Dean27817/Universal-Melty-AIO/README.md

# Universal-Melty-AIO
A repository of code and hardware files for a universal melty board that uses two accelerometers to make a PCB that should be able to work in any meltybrain battlebot.
