Dean27817/Universal-Melty-AIO/PCB/AIOMeltyV3.kicad_pcb

## KiCad design PCB/AIOMeltyV3.kicad_pcb (2025-08-06)

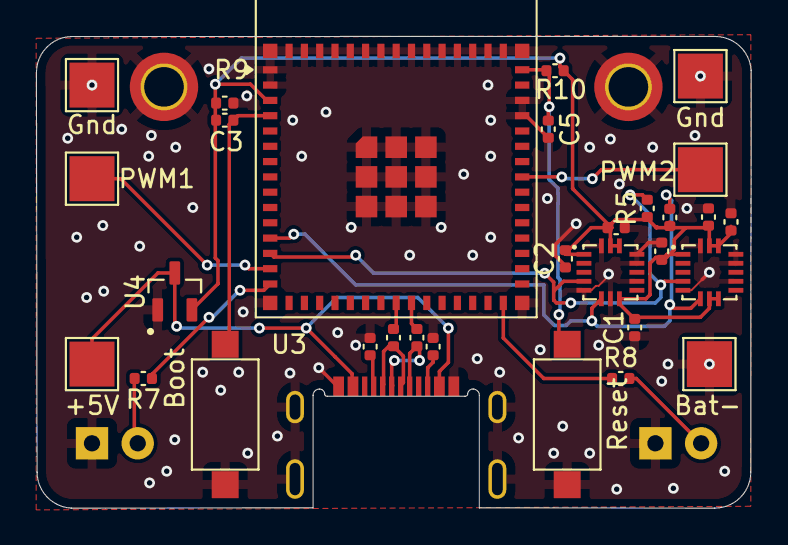
[picture p1: board AIOMeltyV3.kicad_pcb from above]

Board: 2 copper layers, 39.7 x 26.2 mm, 33 parts (0 on the bottom side), 17 nets.

Parts:
C1, C1#2, C2, C3, C4, C5, C12, C13: 100nf; C_0402_1005Metric
D1, D2: CQY99; LED_D5.0mm_IRGrey
H1: PWM1; TestPoint_Pad_2.5x2.5mm
H2: PWM2; TestPoint_Pad_2.5x2.5mm
H3: Bat-; TestPoint_Pad_2.5x2.5mm
H3#2, H3#3: Gnd; TestPoint_Pad_2.5x2.5mm
H4: +5V; TestPoint_Pad_2.5x2.5mm
J1: USB4500-03-0-A_REVA1; GCT_USB4500-03-0-A_REVA1
R1, R2: 27.4; C_0402_1005Metric
R3, R4: 5.1k; C_0402_1005Metric
R5, R6, R9, R10: 10k; C_0402_1005Metric
R7, R8: R; C_0402_1005Metric
SW1: Boot; SW_SPST_CK_RS282G05A3
SW2: Reset; SW_SPST_CK_RS282G05A3
U1, U2: QFN300X300X100-16N
U3: ESP32-S3-MINI-1; ESP32-S2-MINI-1
U4: RT9161A-33GV; 5-3.3V LDO

Connections:
+3V3: C1.2, C1#2.2, C2.2, C3.2, C4.1, C12.1, C13.1, R5.1, R6.1, R9.1, R10.1, U1.1 (VDD_IO), U1.8 (CS), U1.14 (VDD), U1.15 (VDD), U2.1 (VDD_IO), U2.7 (SDO), U2.8 (CS), U2.14 (VDD), U2.15 (VDD), U3.3 (3V3), U4.2 (VOUT)
+5V: J1.A4_B9 (VBUS_A), J1.B4_A9 (VBUS_B), U4.3 (VIN)
GND: C1.1, C1#2.1, C2.1, C3.1, C4.2, C5.1, C12.2, C13.2, D1.1 (K), D2.1 (K), H3.1, H3#2.1, H3#3.1, J1.A1_B12 (GND_A), J1.B1_A12 (GND_B), J1.SH1 (SHELL_GND), J1.SH2 (SHELL_GND), J1.SH3 (SHELL_GND), J1.SH4 (SHELL_GND), R3.2, R4.2, SW1.1, SW2.1, U1.5 (GND), U1.7 (SDO), U1.10 (GND), U1.12 (GND), U1.13 (GND), U1.16 (GND), U2.5 (GND), U2.10 (GND), U2.12 (GND), U2.13 (GND), U2.16 (GND), U3.1 (GND), U3.2 (GND), U3.42 (GND), U3.43 (GND), U3.46 (GND), U3.47 (GND), U3.48 (GND), U3.49 (GND), U3.50 (GND), U3.51 (GND), U3.52 (GND), U3.53 (GND), U3.54 (GND), U3.55 (GND), U3.56 (GND), U3.57 (GND), U3.58 (GND), U3.59 (GND), U3.60 (GND), U3.61 (GND), U3.62 (GND), U3.63 (GND), U3.64 (GND), U3.65 (GND), U4.1 (GND)
Header: R8.1, U3.30 (IO48)
unnamed: D1.2 (A), R7.2
unnamed: D2.2 (A), R8.2
unnamed: J1.A5 (CC1), R4.1
unnamed: J1.B5 (CC2), R3.1
unnamed: C5.2, R10.2, SW2.2, U3.45 (EN)
unnamed: R9.2, SW1.2, U3.4 (IO0)
Power: R7.1, U3.15 (IO11)
SCL: R5.2, U1.4 (SCL), U2.4 (SCL), U3.13 (IO9)
SDA: R6.2, U1.6 (SDA), U2.6 (SDA), U3.12 (IO8)
USB1_N: J1.A7 (DN1), J1.B7 (DN2), R1.1
USB1_P: J1.A6 (DP1), J1.B6 (DP2), R2.2
USB_N: R1.2, U3.23 (USB_D-)
USB_P: R2.1, U3.24 (USB_D+)
