Dean27817/Universal-Melty-AIO/(commit log)

2025-06-05 Added PCB flies
    I have had the PCB done for a bit and am now uploading all the files
    [AIOMeltyV3.kicad_pcb, AIOMeltyV3.kicad_sch]
2025-06-05 Added old code files
    This is the code from a previous Meltybrain, HDD. It only works with one accelerometer and is currently a mess. This will be changed, but it is good to have here as a backup.
    [OTAUpdates.h, main.cpp]
2025-07-26 changed code over to work with the new PCB
    [AIOMeltyV3.kicad_pcb, AIOMeltyV3.kicad_sch]
2025-07-27 some things work. I think there may be hardware issues
    [main.cpp]
2025-07-27 updated PCB
    [AIOMeltyV3.kicad_pcb, AIOMeltyV3BOM.csv]
2025-07-29 Robot moves, I2C should now be on the correct pins
    [AIOMeltyV3.kicad_pcb, AIOMeltyV3.kicad_sch]
2025-07-29 I think I finally fixed the kinimatics
    [main.cpp]
2025-08-06 updated PCB I2C
    [AIOMeltyV3-B_Cu.gbr, AIOMeltyV3-B_Mask.gbr, AIOMeltyV3-B_Paste.gbr, AIOMeltyV3-B_Silkscreen.gbr, AIOMeltyV3-Edge_Cuts.gbr, AIOMeltyV3-F_Cu.gbr, AIOMeltyV3-F_Mask.gbr, AIOMeltyV3-F_Paste.gbr]
2025-08-13 changed wifi code. No longer need to connect at startup
    [main.cpp]
2025-08-15 added safety to last code
    [AIOMeltyV3-B_Cu.gbr, AIOMeltyV3-B_Mask.gbr, AIOMeltyV3-B_Paste.gbr, AIOMeltyV3-B_Silkscreen.gbr, AIOMeltyV3-Edge_Cuts.gbr, AIOMeltyV3-F_Cu.gbr, AIOMeltyV3-F_Mask.gbr, AIOMeltyV3-F_Paste.gbr]
2025-10-06 push before switching to ELRS
2026-01-09 I belive this is PIO updating librarys
    [AIOMeltyV3.kicad_sch]
2026-01-09 added configs
    [kinimatics.cfg]
